rastrocchia46/Buck_Converter/3D View.pdf

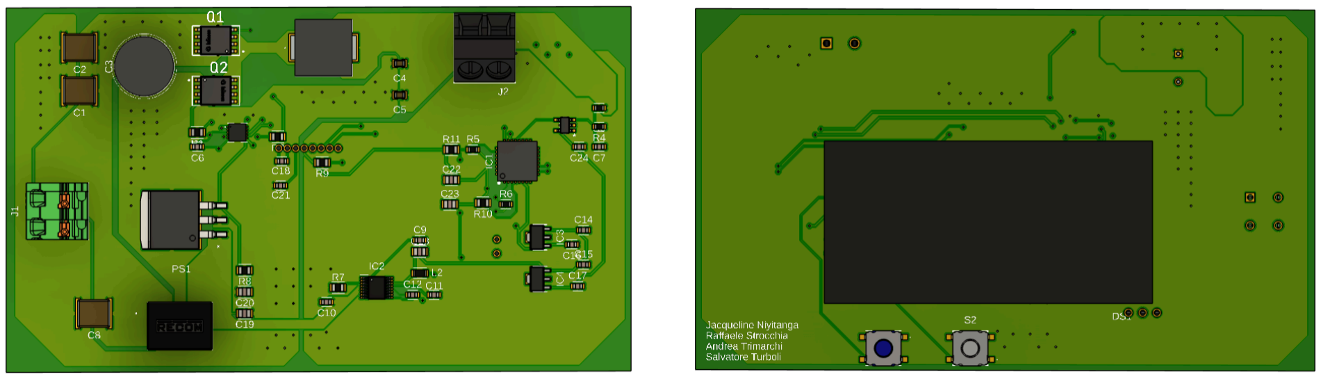
[picture p1: page 1]
