rastrocchia46/Buck_Converter/Bill of Material.xlsx

Sheet: EXAM v23 (2)
Column1 | Column2 | Column3 | Column4 | Column5 | Column6 | Column7 | Column8 | Column9 | Column10 | Column11 | Column12 | Column13 | Column14 | Column15 | Column16 | Column17 | Column18 | Column19 | Column20 | Column21 | Column22 | Column23 | Column24 | Column25 | Column26 | Column27 | Column28 | Column29 | Column30
Part | Value | Device | Package | Description | CATEGORY | COPYRIGHT | CURRENT_RATING | DATASHEET | DESCRIPTION | HEIGHT | MANUFACTURER | MANUFACTURER_NAME | MANUFACTURER_PART_NUMBER | MATERIAL_CORE | MOUSER_PART_NUMBER | MOUSER_PRICE-STOCK | MPN | OPERATING_TEMPERATURE | PACKAGE_SIZE | PACKAGE_TYPE | PART_STATUS | ROHS | SERIES | SUBCATEGORY | TEMPERATURE_COEFFICIENT | THERMALLOSS | TOLERANCE | TYPE | VOLTAGE_RATING
C1 | GRM55ER72A475KA01 | GRM55ER72A475KA01 | GRM55ER72A475KA01 | Ceramic SMT capacitor 4.7uF 100Vdc |  |  |  |  | Ceramic SMT capacitor 4.7uF 100Vdc | 2.7mm |  | Murata Electronics | GRM55ER72A475KA01L |  | 81-GRM55ER72A475KA01 | https://www.mouser.com/Search/Refine.aspx?Keyword=81-GRM55ER72A475KA01
C2 | GRM55ER72A475KA01 | GRM55ER72A475KA01 | GRM55ER72A475KA01 | Ceramic SMT capacitor 4.7uF 100Vdc |  |  |  |  | Ceramic SMT capacitor 4.7uF 100Vdc | 2.7mm |  | Murata Electronics | GRM55ER72A475KA01L |  | 81-GRM55ER72A475KA01 | https://www.mouser.com/Search/Refine.aspx?Keyword=81-GRM55ER72A475KA01
C3 | MAL213639479E3 | MAL213639479E3 | MAL213639479E3 | Vishay 47F 100V dc Aluminium Electrolytic Capacitor, Through Hole 10 (Dia.) x 16mm +105C 10mm 5mm |  |  |  |  | Vishay 47F 100V dc Aluminium Electrolytic Capacitor | Through Hole 10 (Dia.) x 16mm +105C 10mm 5mm | 17.5mm |  | Vishay | MAL213639479E3 |  | N/A | https://www.mouser.com/Search/Refine.aspx?Keyword=N%2FA
C4 | GRM21BR61C226ME44K | GRM21BR61C226ME44K | CAPC2012X145N | Multilayer Ceramic Capacitors MLCC - SMD/SMT |  |  |  |  | Multilayer Ceramic Capacitors MLCC - SMD/SMT | 1.45mm |  | Murata Electronics | GRM21BR61C226ME44K |  | 81-GRM21BR61C226ME4K | https://www.mouser.co.uk/ProductDetail/Murata-Electronics/GRM21BR61C226ME44K?qs=hNud%2FORuBR2WdjhUPKC1mw%3D%3D
C5 | GRM21BR61C226ME44K | GRM21BR61C226ME44K | CAPC2012X145N | Multilayer Ceramic Capacitors MLCC - SMD/SMT |  |  |  |  | Multilayer Ceramic Capacitors MLCC - SMD/SMT | 1.45mm |  | Murata Electronics | GRM21BR61C226ME44K |  | 81-GRM21BR61C226ME4K | https://www.mouser.co.uk/ProductDetail/Murata-Electronics/GRM21BR61C226ME44K?qs=hNud%2FORuBR2WdjhUPKC1mw%3D%3D
C6 | 7.2n | C_CHIP-0603(1608-METRIC) | CAPC1608X85 | Capacitor - Generic | Capacitor |  |  |  |  |  |  |  |  |  |  |  |  |  | 0603 | Surface Mount |  |  |  | Ceramic Capacitors |  |  |  | MLCC
C7 | 1.5n | C_CHIP-0603(1608-METRIC) | CAPC1608X85 | Capacitor - Generic | Capacitor |  |  |  |  |  |  |  |  |  |  |  |  |  | 0603 | Surface Mount |  |  |  | Ceramic Capacitors |  |  |  | MLCC
C8 | GRM55ER72A475KA01 | GRM55ER72A475KA01 | GRM55ER72A475KA01 | Ceramic SMT capacitor 4.7uF 100Vdc |  |  |  |  | Ceramic SMT capacitor 4.7uF 100Vdc | 2.7mm |  | Murata Electronics | GRM55ER72A475KA01L |  | 81-GRM55ER72A475KA01 | https://www.mouser.com/Search/Refine.aspx?Keyword=81-GRM55ER72A475KA01
C9 | 1u | C_CHIP-0603(1608-METRIC) | CAPC1608X85 | Capacitor - Generic | Capacitor |  |  |  |  |  |  |  |  |  |  |  |  |  | 0603 | Surface Mount |  |  |  | Ceramic Capacitors |  |  |  | MLCC
C10 | 4.7u | C_CHIP-0603(1608-METRIC) | CAPC1608X85 | Capacitor - Generic | Capacitor |  |  |  |  |  |  |  |  |  |  |  |  |  | 0603 | Surface Mount |  |  |  | Ceramic Capacitors |  |  |  | MLCC
C11 | 1u | C_CHIP-0603(1608-METRIC) | CAPC1608X85 | Capacitor - Generic | Capacitor |  |  |  |  |  |  |  |  |  |  |  |  |  | 0603 | Surface Mount |  |  |  | Ceramic Capacitors |  |  |  | MLCC
C12 | 0.1u | C_CHIP-0603(1608-METRIC) | CAPC1608X85 | Capacitor - Generic | Capacitor |  |  |  |  |  |  |  |  |  |  |  |  |  | 0603 | Surface Mount |  |  |  | Ceramic Capacitors |  |  |  | MLCC
C13 | 100u | C_CHIP-0805(2012-METRIC) | CAPC2012X110 | Capacitor - Generic | Capacitor |  |  |  |  |  |  |  |  |  |  |  |  |  | 0805 | Surface Mount |  |  |  | Ceramic Capacitors |  |  |  | MLCC
C14 | 1u | C_CHIP-0603(1608-METRIC) | CAPC1608X85 | Capacitor - Generic | Capacitor |  |  |  |  |  |  |  |  |  |  |  |  |  | 0603 | Surface Mount |  |  |  | Ceramic Capacitors |  |  |  | MLCC
C15 | 1u | C_CHIP-0603(1608-METRIC) | CAPC1608X85 | Capacitor - Generic | Capacitor |  |  |  |  |  |  |  |  |  |  |  |  |  | 0603 | Surface Mount |  |  |  | Ceramic Capacitors |  |  |  | MLCC
C16 | 1u | C_CHIP-0603(1608-METRIC) | CAPC1608X85 | Capacitor - Generic | Capacitor |  |  |  |  |  |  |  |  |  |  |  |  |  | 0603 | Surface Mount |  |  |  | Ceramic Capacitors |  |  |  | MLCC
C17 | 1u | C_CHIP-0603(1608-METRIC) | CAPC1608X85 | Capacitor - Generic | Capacitor |  |  |  |  |  |  |  |  |  |  |  |  |  | 0603 | Surface Mount |  |  |  | Ceramic Capacitors |  |  |  | MLCC
C18 | 1u | C_CHIP-0603(1608-METRIC) | CAPC1608X85 | Capacitor - Generic | Capacitor |  |  |  |  |  |  |  |  |  |  |  |  |  | 0603 | Surface Mount |  |  |  | Ceramic Capacitors |  |  |  | MLCC
C19 | 0.47u | C_CHIP-0805(2012-METRIC) | CAPC2012X110 | Capacitor - Generic | Capacitor |  |  |  |  |  |  |  |  |  |  |  |  |  | 0805 | Surface Mount |  |  |  | Ceramic Capacitors |  |  |  | MLCC
C20 | 22u | C_CHIP-0805(2012-METRIC) | CAPC2012X110 | Capacitor - Generic | Capacitor |  |  |  |  |  |  |  |  |  |  |  |  |  | 0805 | Surface Mount |  |  |  | Ceramic Capacitors |  |  |  | MLCC
C21 | 1u | C_CHIP-0603(1608-METRIC) | CAPC1608X85 | Capacitor - Generic | Capacitor |  |  |  |  |  |  |  |  |  |  |  |  |  | 0603 | Surface Mount |  |  |  | Ceramic Capacitors |  |  |  | MLCC
C22 | 0.1u | C_CHIP-0805(2012-METRIC) | CAPC2012X110 | Capacitor - Generic | Capacitor |  |  |  |  |  |  |  |  |  |  |  |  |  | 0805 | Surface Mount |  |  |  | Ceramic Capacitors |  |  |  | MLCC
C23 | 0.1u | C_CHIP-0805(2012-METRIC) | CAPC2012X110 | Capacitor - Generic | Capacitor |  |  |  |  |  |  |  |  |  |  |  |  |  | 0805 | Surface Mount |  |  |  | Ceramic Capacitors |  |  |  | MLCC
C24 | 0.1u | C_CHIP-0603(1608-METRIC) | CAPC1608X85 | Capacitor - Generic | Capacitor |  |  |  |  |  |  |  |  |  |  |  |  |  | 0603 | Surface Mount |  |  |  | Ceramic Capacitors |  |  |  | MLCC
DS1 | NHD-C0216CIZ-FSW-FBW-3V3 | NHD-C0216CIZ-FSW-FBW-3V3 | NHD-C0216CIZ-FSW-FBW-3V3 | LCD Character Display Modules & Accessories FSTN (+) Transfl 56.0 x 25.3 x 5.5 |  |  |  |  | LCD Character Display Modules & Accessories FSTN (+) Transfl 56.0 x 25.3 x 5.5 | mm |  | Newhaven Display | NHD-C0216CiZ-FSW-FBW-3V3 |  | 763-C0216CIZFSWFBW3V | https://www.mouser.co.uk/ProductDetail/Newhaven-Display/NHD-C0216CiZ-FSW-FBW-3V3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
IC1 | LPC1313FHN33_01,55 | LPC1313FHN33_01,55 | QFN65P700X700X100-33N | ARM Microcontrollers - MCU 32B CORTEX-M3 32KB FL/8KB SRAM |  |  |  |  | ARM Microcontrollers - MCU 32B CORTEX-M3 32KB FL/8KB SRAM | 1mm |  | NXP | LPC1313FHN33/01 | 55 |  | 771-LPC1313FHN330155 | https://www.mouser.co.uk/ProductDetail/NXP-Semiconductors/LPC1313FHN33-0155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
IC2 | LT8610AEMSE#PBF | LT8610AEMSE#PBF | LT8610A | Linear Technology, LT8610AEMSE#PBF DC-DC Converter 2.5A Adjustable 16-Pin, MSOP |  |  |  |  | Linear Technology | LT8610AEMSE#PBF DC-DC Converter 2.5A Adjustable 16-Pin | MSOP | 1.1mm |  | Analog Devices | LT8610AEMSE#PBF |  | 584-LT8610AEMSE#PBF | https://www.mouser.co.uk/ProductDetail/Analog-Devices/LT8610AEMSEPBF?qs=hVkxg5c3xu%252BXCM0J%252BSz08Q%3D%3D
IC3 | AP7387Q-33Y-13 | AP7387Q-33Y-13 | AP7387Q | LDO Voltage Regulators LDO CMOS LowCurr SOT89 T&R 2.5K |  |  |  |  | LDO Voltage Regulators LDO CMOS LowCurr SOT89 T&R 2.5K | mm |  | Diodes Incorporated | AP7387Q-33Y-13 |  | 621-AP7387Q-33Y-13 | https://www.mouser.co.uk/ProductDetail/Diodes-Incorporated/AP7387Q-33Y-13?qs=Y0Uzf4wQF3kvZEnH8zEZig%3D%3D
IC4 | AP7387Q-33Y-13 | AP7387Q-33Y-13 | AP7387Q | LDO Voltage Regulators LDO CMOS LowCurr SOT89 T&R 2.5K |  |  |  |  | LDO Voltage Regulators LDO CMOS LowCurr SOT89 T&R 2.5K | mm |  | Diodes Incorporated | AP7387Q-33Y-13 |  | 621-AP7387Q-33Y-13 | https://www.mouser.co.uk/ProductDetail/Diodes-Incorporated/AP7387Q-33Y-13?qs=Y0Uzf4wQF3kvZEnH8zEZig%3D%3D
J1 | 1071045 | 1071045 | 1071045 | 1-Fixed Terminal Blocks SPTAF 1/ 2-5 0-EL-EX |  |  |  |  | 1-Fixed Terminal Blocks SPTAF 1/ 2-5 0-EL-EX | 10.2mm |  | Phoenix Contact | 1071045 |  | 651-1071045 | https://www.mouser.co.uk/ProductDetail/Phoenix-Contact/1071045?qs=CUBnOrq4ZJwaBOz3kExfEw%3D%3D
J2 | 39543-4302 | 39543-4302 | 395434302 | (5.00mm) Through Hole |  |  |  |  | (5.00mm) Through Hole | 12.6mm |  | Molex | 39543-4302 |  | 538-39543-4302 | https://www.mouser.co.uk/ProductDetail/Molex/39543-4302?qs=4dAX1jW9NQpntxHfWEE3YA%3D%3D
L1 | SRP1038WA-4R7M | SRP1038WA-4R7M | SRP1038WA4R7M | Ind,11x10x3.8mm,4.7uH+/-20%,11A,shd |  |  |  |  | Ind | 11x10x3.8mm | 4.7uH+/-20% | 11A | shd | 4mm |  | Bourns | SRP1038WA-4R7M |  | 652-SRP1038WA-4R7M | https://www.mouser.co.uk/ProductDetail/Bourns/SRP1038WA-4R7M?qs=Li%252BoUPsLEnt%252BeSqNInK2UA%3D%3D
L2 | 10u | L_CHIP-0805(2012-METRIC) | INDC2009X120 | Inductor Fixed - Generic | Inductors |  |  |  | Chip 2.00 X 0.90 X 1.20 mm body 0805(2012-METRIC) |  |  |  |  |  |  |  |  |  | 0805 | Surface Mount
PS1 | R-78HB15-0.5 | R-78HB15-0.5 | R78HB3305 | Recom Switching Regulator, 20 ??72V Input, 15V Output, 0.5A%0 |  |  |  |  | Recom Switching Regulator | 20 ??72V Input | 15V Output | 0.5A%0 | 17.5mm |  | RECOM Power | R-78HB15-0.5 |  | 919-R-78HB15-0.5 | https://www.mouser.co.uk/ProductDetail/RECOM-Power/R-78HB15-05?qs=XF8hdbuHJAXLTh4WSjHftA%3D%3D
Q1 | IAUCN10S7L040 | IAUCN10S7L040 | IAUCN10S7L040
Q2 | IAUCN10S7L040 | IAUCN10S7L040 | IAUCN10S7L040
R1 | 1.3 | R_CHIP-0805(2012-METRIC) | RESC2012X65 | Resistor Fixed - Generic | Resistors |  |  |  | Chip Resistor 2.00 X 1.25 X 0.65 mm body 0805(2012-METRIC) Package |  |  |  |  |  |  |  |  |  | 0805 | Surface Mount
R2 | 1.3 | R_CHIP-0805(2012-METRIC) | RESC2012X65 | Resistor Fixed - Generic | Resistors |  |  |  | Chip Resistor 2.00 X 1.25 X 0.65 mm body 0805(2012-METRIC) Package |  |  |  |  |  |  |  |  |  | 0805 | Surface Mount
R3 | 10k | R_CHIP-0603(1608-METRIC) | RESC1608X60 | Resistor Fixed - Generic | Resistors |  |  |  | Chip Resistor 1.60 X 0.82 X 0.60 mm body 0603(1608-METRIC) Package |  |  |  |  |  |  |  |  |  | 0603 | Surface Mount
R4 | 20k | R_CHIP-0603(1608-METRIC) | RESC1608X60 | Resistor Fixed - Generic | Resistors |  |  |  | Chip Resistor 1.60 X 0.82 X 0.60 mm body 0603(1608-METRIC) Package |  |  |  |  |  |  |  |  |  | 0603 | Surface Mount
R5 | 10k | R_CHIP-0603(1608-METRIC) | RESC1608X60 | Resistor Fixed - Generic | Resistors |  |  |  | Chip Resistor 1.60 X 0.82 X 0.60 mm body 0603(1608-METRIC) Package |  |  |  |  |  |  |  |  |  | 0603 | Surface Mount
R6 | 10k | R_CHIP-0603(1608-METRIC) | RESC1608X60 | Resistor Fixed - Generic | Resistors |  |  |  | Chip Resistor 1.60 X 0.82 X 0.60 mm body 0603(1608-METRIC) Package |  |  |  |  |  |  |  |  |  | 0603 | Surface Mount
R7 | 110k | R_CHIP-0805(2012-METRIC) | RESC2012X65 | Resistor Fixed - Generic | Resistors |  |  |  | Chip Resistor 2.00 X 1.25 X 0.65 mm body 0805(2012-METRIC) Package |  |  |  |  |  |  |  |  |  | 0805 | Surface Mount
R8 | 0.5 | R_CHIP-0805(2012-METRIC) | RESC2012X65 | Resistor Fixed - Generic | Resistors |  |  |  | Chip Resistor 2.00 X 1.25 X 0.65 mm body 0805(2012-METRIC) Package |  |  |  |  |  |  |  |  |  | 0805 | Surface Mount
R9 | 22 | R_CHIP-0805(2012-METRIC) | RESC2012X65 | Resistor Fixed - Generic | Resistors |  |  |  | Chip Resistor 2.00 X 1.25 X 0.65 mm body 0805(2012-METRIC) Package |  |  |  |  |  |  |  |  |  | 0805 | Surface Mount
R10 | 10k | R_CHIP-0805(2012-METRIC) | RESC2012X65 | Resistor Fixed - Generic | Resistors |  |  |  | Chip Resistor 2.00 X 1.25 X 0.65 mm body 0805(2012-METRIC) Package |  |  |  |  |  |  |  |  |  | 0805 | Surface Mount
R11 | 10k | R_CHIP-0805(2012-METRIC) | RESC2012X65 | Resistor Fixed - Generic | Resistors |  |  |  | Chip Resistor 2.00 X 1.25 X 0.65 mm body 0805(2012-METRIC) Package |  |  |  |  |  |  |  |  |  | 0805 | Surface Mount
S1 | KSC721J_LFS | KSC721J_LFS | KSC721JLFS | Tactile Switches 4.3mmIP67 1.6N Soft Actuator J-Bend |  |  |  |  | Tactile Switches 4.3mmIP67 1.6N Soft Actuator J-Bend | 4.7mm |  | C & K COMPONENTS | KSC721J LFS |  | 611-KSC721JLFS | http://www.mouser.com/Search/ProductDetail.aspx?qs=15Q3o2KSIZY%2f1aaKjFUM2A%3d%3d
S2 | KSC253J_SP_DELTA_LFG | KSC253J_SP_DELTA_LFG | KSC253JSPDELTALFG | Tactile Switches 6.2 x 6.2mm, 3.mm height soft actuator, 5.5N, gold contact material |  |  |  |  | Tactile Switches 6.2 x 6.2mm | 3.mm height soft actuator | 5.5N | gold contact material | 3.5mm |  | C & K COMPONENTS | KSC253J SP DELTA LFG |  | 611-KSC253JSPDELTALF | https://www.mouser.co.uk/ProductDetail/CK/KSC253J-SP-DELTA-LFG?qs=i8QVZAFTkqRm%252BD28PDm3qw%3D%3D
U1 | TLV2781CDBVRDBV5 | TLV2781CDBVRDBV5 | DBV5 |  |  | Copyright (C) 2025 Ultra Librarian. All rights reserved. |  | https://www.ti.com/lit/gpn/tlv2781 | Single | 3.6-V | 8-MHz | RRIO operational amplifier 5-SOT-23 0 to 70 |  |  | Texas Instruments | TLV2781CDBVR
U2 | UCC27282DRCRVSON10_DRC_TEX | UCC27282DRCRVSON10_DRC_TEX | UCC27282 |  |  | Copyright (C) 2025 Ultra Librarian. All rights reserved. |  | https://www.ti.com/lit/gpn/ucc27282 | 3-A | 120-V half-bridge gate driver with 5-V UVLO | interlock and enable 10-VSON -40 to 125 |  |  | Texas Instruments | UCC27282DRCR
U3 | LM2940CS-12TS3B | LM2940CS-12TS3B | TS3B |  |  | Copyright (C) 2025 Ultra Librarian. All rights reserved. |  | https://www.ti.com/lit/gpn/lm2940c | 1-A | 26-V | high-PSRR | low-dropout voltage regulator 3-DDPAK/TO-263 0 to 125 |  |  | Texas Instruments | LM2940CS-12

Sheet: EXAM v23
Part,Value,Device,Package,Description,CATEGORY,COPYRIGHT,CURRENT_RATING,DATASHEET,DESCRIPTION,HEIGHT,MANUFACTURER,MANUFACTURER_NAME,MANUFACTURER_PART_NUMBER,MATERIAL_CORE,MOUSER_PART_NUMBER,MOUSER_PRICE-STOCK,MPN,OPERATING_TEMPERATURE,PACKAGE_SIZE,PACKAGE_TYPE,PART_STATUS,ROHS,SERIES,SUBCATEGORY,TEMPERATURE_COEFFICIENT,THERMALLOSS,TOLERANCE,TYPE,VOLTAGE_RATING
C1,GRM55ER72A475KA01,GRM55ER72A475KA01,GRM55ER72A475KA01,"Ceramic SMT capacitor 4.7uF 100Vdc",,,,,"Ceramic SMT capacitor 4.7uF 100Vdc",2.7mm,,"Murata Electronics",GRM55ER72A475KA01L,,81-GRM55ER72A475KA01,https://www.mouser.com/Search/Refine.aspx?Keyword=81-GRM55ER72A475KA01,,,,,,,,,,,,,
C2,GRM55ER72A475KA01,GRM55ER72A475KA01,GRM55ER72A475KA01,"Ceramic SMT capacitor 4.7uF 100Vdc",,,,,"Ceramic SMT capacitor 4.7uF 100Vdc",2.7mm,,"Murata Electronics",GRM55ER72A475KA01L,,81-GRM55ER72A475KA01,https://www.mouser.com/Search/Refine.aspx?Keyword=81-GRM55ER72A475KA01,,,,,,,,,,,,,
C3,MAL213639479E3,MAL213639479E3,MAL213639479E3,"Vishay 47F 100V dc Aluminium Electrolytic Capacitor, Through Hole 10 (Dia.) x 16mm +105C 10mm 5mm",,,,,"Vishay 47F 100V dc Aluminium Electrolytic Capacitor"," Through Hole 10 (Dia.) x 16mm +105C 10mm 5mm",17.5mm,,Vishay,MAL213639479E3,,N/A,https://www.mouser.com/Search/Refine.aspx?Keyword=N%2FA,,,,,,,,,,,,
C4,GRM21BR61C226ME44K,GRM21BR61C226ME44K,CAPC2012X145N,"Multilayer Ceramic Capacitors MLCC - SMD/SMT",,,,,"Multilayer Ceramic Capacitors MLCC - SMD/SMT",1.45mm,,"Murata Electronics",GRM21BR61C226ME44K,,81-GRM21BR61C226ME4K,https://www.mouser.co.uk/ProductDetail/Murata-Electronics/GRM21BR61C226ME44K?qs=hNud%2FORuBR2WdjhUPKC1mw%3D%3D,,,,,,,,,,,,,
C5,GRM21BR61C226ME44K,GRM21BR61C226ME44K,CAPC2012X145N,"Multilayer Ceramic Capacitors MLCC - SMD/SMT",,,,,"Multilayer Ceramic Capacitors MLCC - SMD/SMT",1.45mm,,"Murata Electronics",GRM21BR61C226ME44K,,81-GRM21BR61C226ME4K,https://www.mouser.co.uk/ProductDetail/Murata-Electronics/GRM21BR61C226ME44K?qs=hNud%2FORuBR2WdjhUPKC1mw%3D%3D,,,,,,,,,,,,,
C6,7.2n,C_CHIP-0603(1608-METRIC),CAPC1608X85,"Capacitor - Generic",Capacitor,,,,,,,,,,,,,,0603,"Surface Mount",,,,"Ceramic Capacitors",,,,MLCC,
C7,1.5n,C_CHIP-0603(1608-METRIC),CAPC1608X85,"Capacitor - Generic",Capacitor,,,,,,,,,,,,,,0603,"Surface Mount",,,,"Ceramic Capacitors",,,,MLCC,
C8,GRM55ER72A475KA01,GRM55ER72A475KA01,GRM55ER72A475KA01,"Ceramic SMT capacitor 4.7uF 100Vdc",,,,,"Ceramic SMT capacitor 4.7uF 100Vdc",2.7mm,,"Murata Electronics",GRM55ER72A475KA01L,,81-GRM55ER72A475KA01,https://www.mouser.com/Search/Refine.aspx?Keyword=81-GRM55ER72A475KA01,,,,,,,,,,,,,
C9,1u,C_CHIP-0603(1608-METRIC),CAPC1608X85,"Capacitor - Generic",Capacitor,,,,,,,,,,,,,,0603,"Surface Mount",,,,"Ceramic Capacitors",,,,MLCC,
C10,4.7u,C_CHIP-0603(1608-METRIC),CAPC1608X85,"Capacitor - Generic",Capacitor,,,,,,,,,,,,,,0603,"Surface Mount",,,,"Ceramic Capacitors",,,,MLCC,
C11,1u,C_CHIP-0603(1608-METRIC),CAPC1608X85,"Capacitor - Generic",Capacitor,,,,,,,,,,,,,,0603,"Surface Mount",,,,"Ceramic Capacitors",,,,MLCC,
C12,0.1u,C_CHIP-0603(1608-METRIC),CAPC1608X85,"Capacitor - Generic",Capacitor,,,,,,,,,,,,,,0603,"Surface Mount",,,,"Ceramic Capacitors",,,,MLCC,
C13,100u,C_CHIP-0805(2012-METRIC),CAPC2012X110,"Capacitor - Generic",Capacitor,,,,,,,,,,,,,,0805,"Surface Mount",,,,"Ceramic Capacitors",,,,MLCC,
C14,1u,C_CHIP-0603(1608-METRIC),CAPC1608X85,"Capacitor - Generic",Capacitor,,,,,,,,,,,,,,0603,"Surface Mount",,,,"Ceramic Capacitors",,,,MLCC,
C15,1u,C_CHIP-0603(1608-METRIC),CAPC1608X85,"Capacitor - Generic",Capacitor,,,,,,,,,,,,,,0603,"Surface Mount",,,,"Ceramic Capacitors",,,,MLCC,
C16,1u,C_CHIP-0603(1608-METRIC),CAPC1608X85,"Capacitor - Generic",Capacitor,,,,,,,,,,,,,,0603,"Surface Mount",,,,"Ceramic Capacitors",,,,MLCC,
C17,1u,C_CHIP-0603(1608-METRIC),CAPC1608X85,"Capacitor - Generic",Capacitor,,,,,,,,,,,,,,0603,"Surface Mount",,,,"Ceramic Capacitors",,,,MLCC,
C18,1u,C_CHIP-0603(1608-METRIC),CAPC1608X85,"Capacitor - Generic",Capacitor,,,,,,,,,,,,,,0603,"Surface Mount",,,,"Ceramic Capacitors",,,,MLCC,
C19,0.47u,C_CHIP-0805(2012-METRIC),CAPC2012X110,"Capacitor - Generic",Capacitor,,,,,,,,,,,,,,0805,"Surface Mount",,,,"Ceramic Capacitors",,,,MLCC,
C20,22u,C_CHIP-0805(2012-METRIC),CAPC2012X110,"Capacitor - Generic",Capacitor,,,,,,,,,,,,,,0805,"Surface Mount",,,,"Ceramic Capacitors",,,,MLCC,
C21,1u,C_CHIP-0603(1608-METRIC),CAPC1608X85,"Capacitor - Generic",Capacitor,,,,,,,,,,,,,,0603,"Surface Mount",,,,"Ceramic Capacitors",,,,MLCC,
C22,0.1u,C_CHIP-0805(2012-METRIC),CAPC2012X110,"Capacitor - Generic",Capacitor,,,,,,,,,,,,,,0805,"Surface Mount",,,,"Ceramic Capacitors",,,,MLCC,
C23,0.1u,C_CHIP-0805(2012-METRIC),CAPC2012X110,"Capacitor - Generic",Capacitor,,,,,,,,,,,,,,0805,"Surface Mount",,,,"Ceramic Capacitors",,,,MLCC,
C24,0.1u,C_CHIP-0603(1608-METRIC),CAPC1608X85,"Capacitor - Generic",Capacitor,,,,,,,,,,,,,,0603,"Surface Mount",,,,"Ceramic Capacitors",,,,MLCC,
DS1,NHD-C0216CIZ-FSW-FBW-3V3,NHD-C0216CIZ-FSW-FBW-3V3,NHD-C0216CIZ-FSW-FBW-3V3,"LCD Character Display Modules & Accessories FSTN (+) Transfl 56.0 x 25.3 x 5.5",,,,,"LCD Character Display Modules & Accessories FSTN (+) Transfl 56.0 x 25.3 x 5.5",mm,,"Newhaven Display",NHD-C0216CiZ-FSW-FBW-3V3,,763-C0216CIZFSWFBW3V,https://www.mouser.co.uk/ProductDetail/Newhaven-Display/NHD-C0216CiZ-FSW-FBW-3V3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,,,,,,,,,,,,,
IC1,"LPC1313FHN33_01,55","LPC1313FHN33_01,55",QFN65P700X700X100-33N,"ARM Microcontrollers - MCU 32B CORTEX-M3 32KB FL/8KB SRAM",,,,,"ARM Microcontrollers - MCU 32B CORTEX-M3 32KB FL/8KB SRAM",1mm,,NXP,LPC1313FHN33/01,55,,771-LPC1313FHN330155,https://www.mouser.co.uk/ProductDetail/NXP-Semiconductors/LPC1313FHN33-0155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,,,,,,,,,,,,
IC2,LT8610AEMSE#PBF,LT8610AEMSE#PBF,LT8610A,"Linear Technology, LT8610AEMSE#PBF DC-DC Converter 2.5A Adjustable 16-Pin, MSOP",,,,,"Linear Technology"," LT8610AEMSE#PBF DC-DC Converter 2.5A Adjustable 16-Pin"," MSOP",1.1mm,,"Analog Devices",LT8610AEMSE#PBF,,584-LT8610AEMSE#PBF,https://www.mouser.co.uk/ProductDetail/Analog-Devices/LT8610AEMSEPBF
IC3,AP7387Q-33Y-13,AP7387Q-33Y-13,AP7387Q,"LDO Voltage Regulators LDO CMOS LowCurr SOT89 T&R 2.5K",,,,,"LDO Voltage Regulators LDO CMOS LowCurr SOT89 T&R 2.5K",mm,,"Diodes Incorporated",AP7387Q-33Y-13,,621-AP7387Q-33Y-13,https://www.mouser.co.uk/ProductDetail/Diodes-Incorporated/AP7387Q-33Y-13?qs=Y0Uzf4wQF3kvZEnH8zEZig%3D%3D,,,,,,,,,,,,,
IC4,AP7387Q-33Y-13,AP7387Q-33Y-13,AP7387Q,"LDO Voltage Regulators LDO CMOS LowCurr SOT89 T&R 2.5K",,,,,"LDO Voltage Regulators LDO CMOS LowCurr SOT89 T&R 2.5K",mm,,"Diodes Incorporated",AP7387Q-33Y-13,,621-AP7387Q-33Y-13,https://www.mouser.co.uk/ProductDetail/Diodes-Incorporated/AP7387Q-33Y-13?qs=Y0Uzf4wQF3kvZEnH8zEZig%3D%3D,,,,,,,,,,,,,
J1,1071045,1071045,1071045,"1-Fixed Terminal Blocks SPTAF 1/ 2-5 0-EL-EX",,,,,"1-Fixed Terminal Blocks SPTAF 1/ 2-5 0-EL-EX",10.2mm,,"Phoenix Contact",1071045,,651-1071045,https://www.mouser.co.uk/ProductDetail/Phoenix-Contact/1071045?qs=CUBnOrq4ZJwaBOz3kExfEw%3D%3D,,,,,,,,,,,,,
J2,39543-4302,39543-4302,395434302," (5.00mm) Through Hole",,,,," (5.00mm) Through Hole",12.6mm,,Molex,39543-4302,,538-39543-4302,https://www.mouser.co.uk/ProductDetail/Molex/39543-4302?qs=4dAX1jW9NQpntxHfWEE3YA%3D%3D,,,,,,,,,,,,,
L1,SRP1038WA-4R7M,SRP1038WA-4R7M,SRP1038WA4R7M,"Ind,11x10x3.8mm,4.7uH+/-20%,11A,shd",,,,,Ind,11x10x3.8mm,4.7uH+/-20%,11A,shd,4mm,,Bourns,SRP1038WA-4R7M,,652-SRP1038WA-4R7M,https://www.mouser.co.uk/ProductDetail/Bourns/SRP1038WA-4R7M?qs=Li%252BoUPsLEnt%252BeSqNInK2UA%3D%3D,,,,,,,,,
L2,10u,L_CHIP-0805(2012-METRIC),INDC2009X120,"Inductor Fixed - Generic",Inductors,,,,"Chip 2.00 X 0.90 X 1.20 mm body 0805(2012-METRIC)",,,,,,,,,,0805,"Surface Mount",,,,,,,,,
PS1,R-78HB15-0.5,R-78HB15-0.5,R78HB3305,"Recom Switching Regulator, 20 ??72V Input, 15V Output, 0.5A%0",,,,,"Recom Switching Regulator"," 20 ??72V Input"," 15V Output"," 0.5A%0",17.5mm,,"RECOM Power",R-78HB15-0.5,,919-R-78HB15-0.5,https://www.mouser.co.uk/ProductDetail/RECOM-Power/R-78HB15-05?qs=XF8hdbuHJAXLTh4WSjHftA%3D%3D,,,,,,,,,,
Q1,IAUCN10S7L040,IAUCN10S7L040,IAUCN10S7L040,,,,,,,,,,,,,,,,,,,,,,,,,,
Q2,IAUCN10S7L040,IAUCN10S7L040,IAUCN10S7L040,,,,,,,,,,,,,,,,,,,,,,,,,,
R1,1.3,R_CHIP-0805(2012-METRIC),RESC2012X65,"Resistor Fixed - Generic",Resistors,,,,"Chip Resistor 2.00 X 1.25 X 0.65 mm body 0805(2012-METRIC) Package",,,,,,,,,,0805,"Surface Mount",,,,,,,,,
R2,1.3,R_CHIP-0805(2012-METRIC),RESC2012X65,"Resistor Fixed - Generic",Resistors,,,,"Chip Resistor 2.00 X 1.25 X 0.65 mm body 0805(2012-METRIC) Package",,,,,,,,,,0805,"Surface Mount",,,,,,,,,
R3,10k,R_CHIP-0603(1608-METRIC),RESC1608X60,"Resistor Fixed - Generic",Resistors,,,,"Chip Resistor 1.60 X 0.82 X 0.60 mm body 0603(1608-METRIC) Package",,,,,,,,,,0603,"Surface Mount",,,,,,,,,
R4,20k,R_CHIP-0603(1608-METRIC),RESC1608X60,"Resistor Fixed - Generic",Resistors,,,,"Chip Resistor 1.60 X 0.82 X 0.60 mm body 0603(1608-METRIC) Package",,,,,,,,,,0603,"Surface Mount",,,,,,,,,
R5,10k,R_CHIP-0603(1608-METRIC),RESC1608X60,"Resistor Fixed - Generic",Resistors,,,,"Chip Resistor 1.60 X 0.82 X 0.60 mm body 0603(1608-METRIC) Package",,,,,,,,,,0603,"Surface Mount",,,,,,,,,
R6,10k,R_CHIP-0603(1608-METRIC),RESC1608X60,"Resistor Fixed - Generic",Resistors,,,,"Chip Resistor 1.60 X 0.82 X 0.60 mm body 0603(1608-METRIC) Package",,,,,,,,,,0603,"Surface Mount",,,,,,,,,
R7,110k,R_CHIP-0805(2012-METRIC),RESC2012X65,"Resistor Fixed - Generic",Resistors,,,,"Chip Resistor 2.00 X 1.25 X 0.65 mm body 0805(2012-METRIC) Package",,,,,,,,,,0805,"Surface Mount",,,,,,,,,
R8,0.5,R_CHIP-0805(2012-METRIC),RESC2012X65,"Resistor Fixed - Generic",Resistors,,,,"Chip Resistor 2.00 X 1.25 X 0.65 mm body 0805(2012-METRIC) Package",,,,,,,,,,0805,"Surface Mount",,,,,,,,,
R9,22,R_CHIP-0805(2012-METRIC),RESC2012X65,"Resistor Fixed - Generic",Resistors,,,,"Chip Resistor 2.00 X 1.25 X 0.65 mm body 0805(2012-METRIC) Package",,,,,,,,,,0805,"Surface Mount",,,,,,,,,
R10,10k,R_CHIP-0805(2012-METRIC),RESC2012X65,"Resistor Fixed - Generic",Resistors,,,,"Chip Resistor 2.00 X 1.25 X 0.65 mm body 0805(2012-METRIC) Package",,,,,,,,,,0805,"Surface Mount",,,,,,,,,
R11,10k,R_CHIP-0805(2012-METRIC),RESC2012X65,"Resistor Fixed - Generic",Resistors,,,,"Chip Resistor 2.00 X 1.25 X 0.65 mm body 0805(2012-METRIC) Package",,,,,,,,,,0805,"Surface Mount",,,,,,,,,
S1,KSC721J_LFS,KSC721J_LFS,KSC721JLFS,"Tactile Switches 4.3mmIP67 1.6N Soft Actuator J-Bend",,,,,"Tactile Switches 4.3mmIP67 1.6N Soft Actuator J-Bend",4.7mm,,"C & K COMPONENTS","KSC721J LFS",,611-KSC721JLFS,http://www.mouser.com/Search/ProductDetail.aspx?qs=15Q3o2KSIZY%2f1aaKjFUM2A%3d%3d,,,,,,,,,,,,,
S2,KSC253J_SP_DELTA_LFG,KSC253J_SP_DELTA_LFG,KSC253JSPDELTALFG,"Tactile Switches 6.2 x 6.2mm, 3.mm height soft actuator, 5.5N, gold contact material",,,,,"Tactile Switches 6.2 x 6.2mm"," 3.mm height soft actuator"," 5.5N"," gold contact material",3.5mm,,"C & K COMPONENTS","KSC253J SP DELTA LFG",,611-KSC253JSPDELTALF,https://www.mouser.co.uk/ProductDetail/CK/KSC253J-SP-DELTA-LFG?qs=i8QVZAFTkqRm%252BD28PDm3qw%3D%3D,,,,,,,,,,
U1,TLV2781CDBVRDBV5,TLV2781CDBVRDBV5,DBV5,,,"Copyright (C) 2025 Ultra Librarian. All rights reserved.",,https://www.ti.com/lit/gpn/tlv2781,Single," 3.6-V"," 8-MHz"," RRIO operational amplifier 5-SOT-23 0 to 70",,,"Texas Instruments",TLV2781CDBVR,,,,,,,,,,,,,
U2,UCC27282DRCRVSON10_DRC_TEX,UCC27282DRCRVSON10_DRC_TEX,UCC27282,,,"Copyright (C) 2025 Ultra Librarian. All rights reserved.",,https://www.ti.com/lit/gpn/ucc27282,3-A," 120-V half-bridge gate driver with 5-V UVLO"," interlock and enable 10-VSON -40 to 125",,,"Texas Instruments",UCC27282DRCR,,,,,,,,,,,,,,
U3,LM2940CS-12TS3B,LM2940CS-12TS3B,TS3B,,,"Copyright (C) 2025 Ultra Librarian. All rights reserved.",,https://www.ti.com/lit/gpn/lm2940c,1-A," 26-V"," high-PSRR"," low-dropout voltage regulator 3-DDPAK/TO-263 0 to 125",,,"Texas Instruments",LM2940CS-12,,,,,,,,,,,,,
