rastrocchia46/Buck_Converter/Schematic v23.pdf

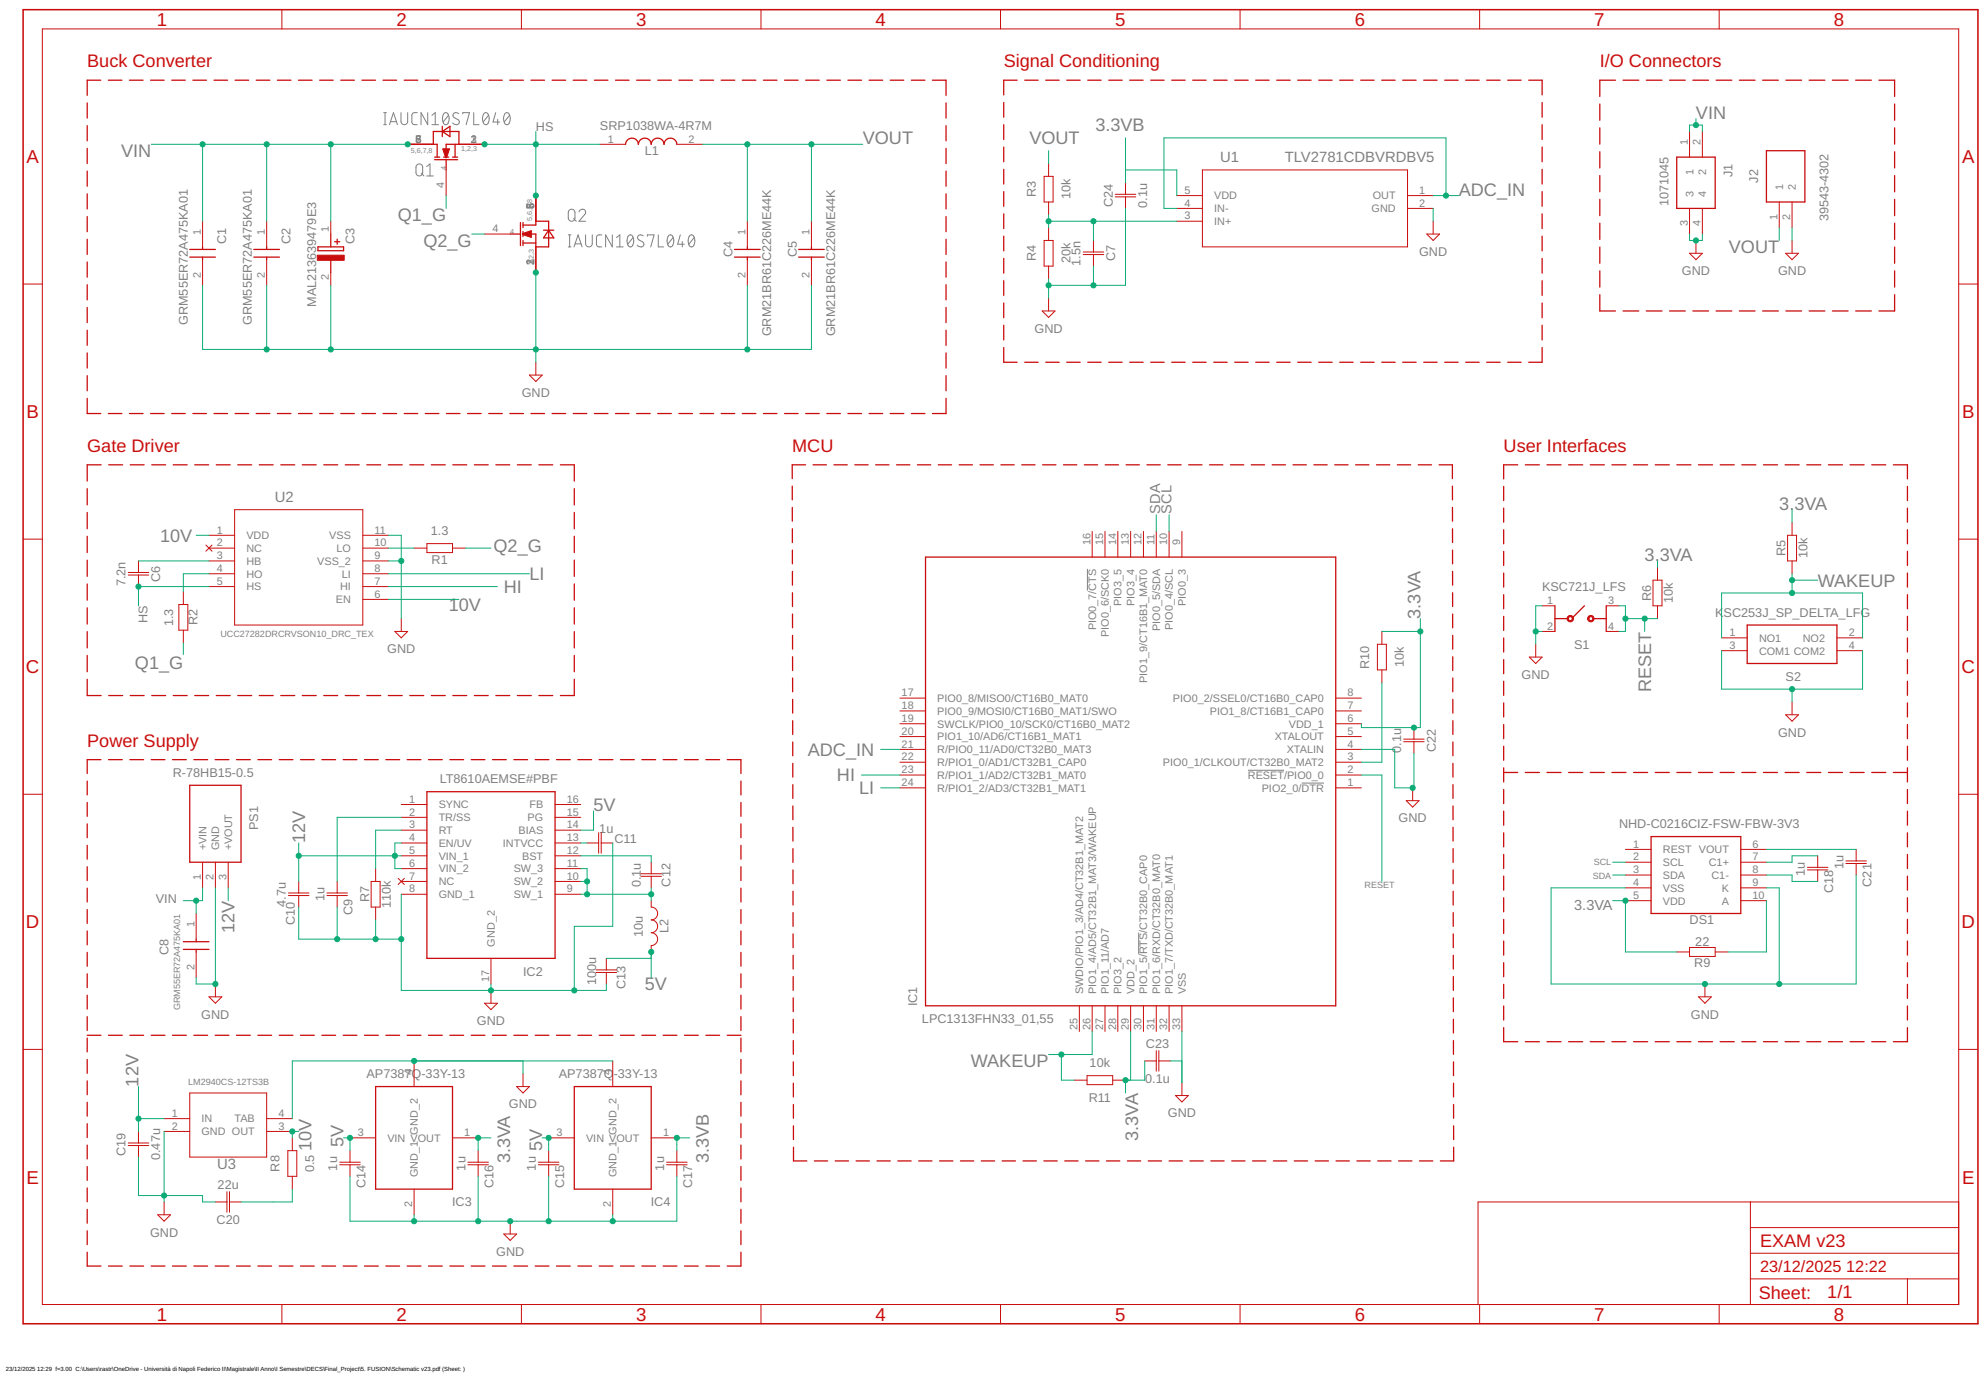
[picture p2: page 1]

Signal Conditioning

23/12/2025 12:29 f=3.00 C:\Users\rastr\OneDrive - Università di Napoli Federico II\Magistrale\II Anno\I Semestre\DECS\Final_Project\5. FUSION\Schematic v23.pdf (Sheet: )
