rastrocchia46/Buck_Converter/PCB_bottom v31.pdf

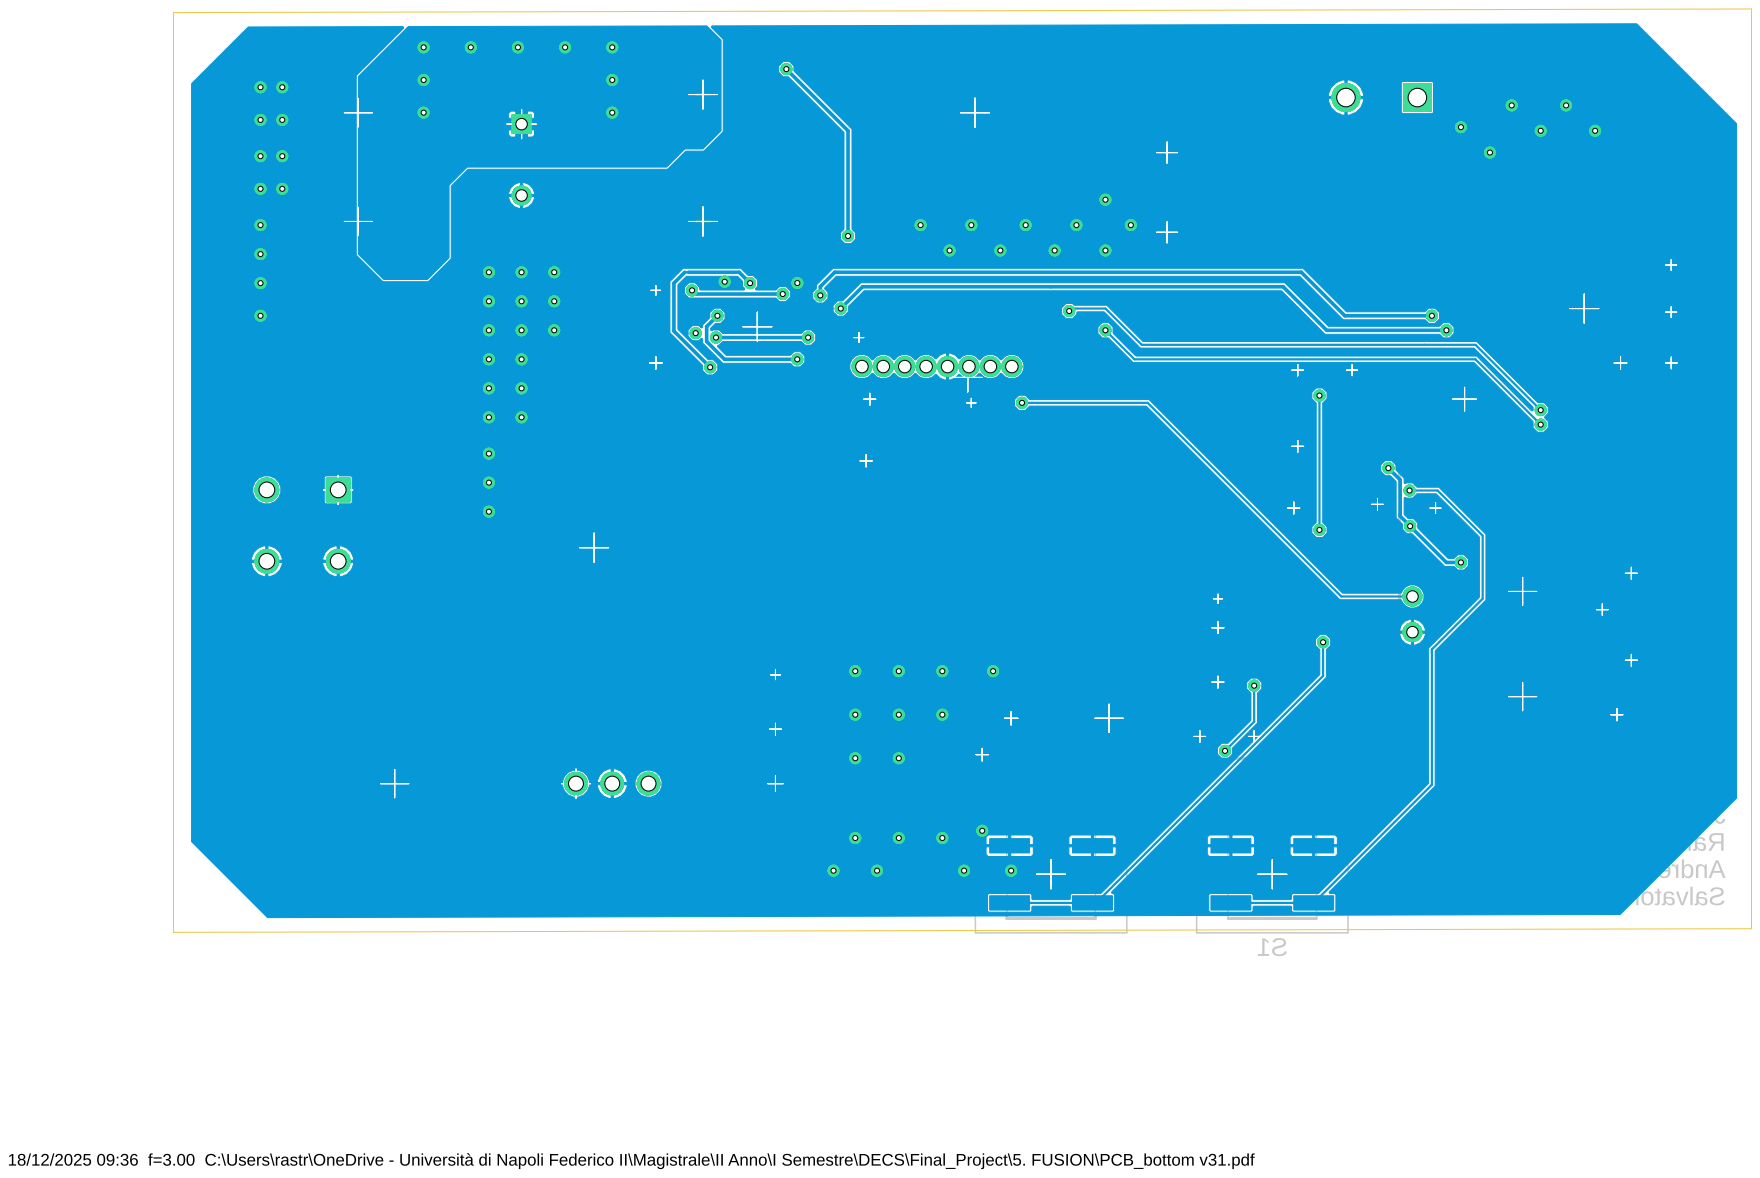
[picture p3: page 1]
