rastrocchia46/Buck_Converter/PCB_top v31.pdf

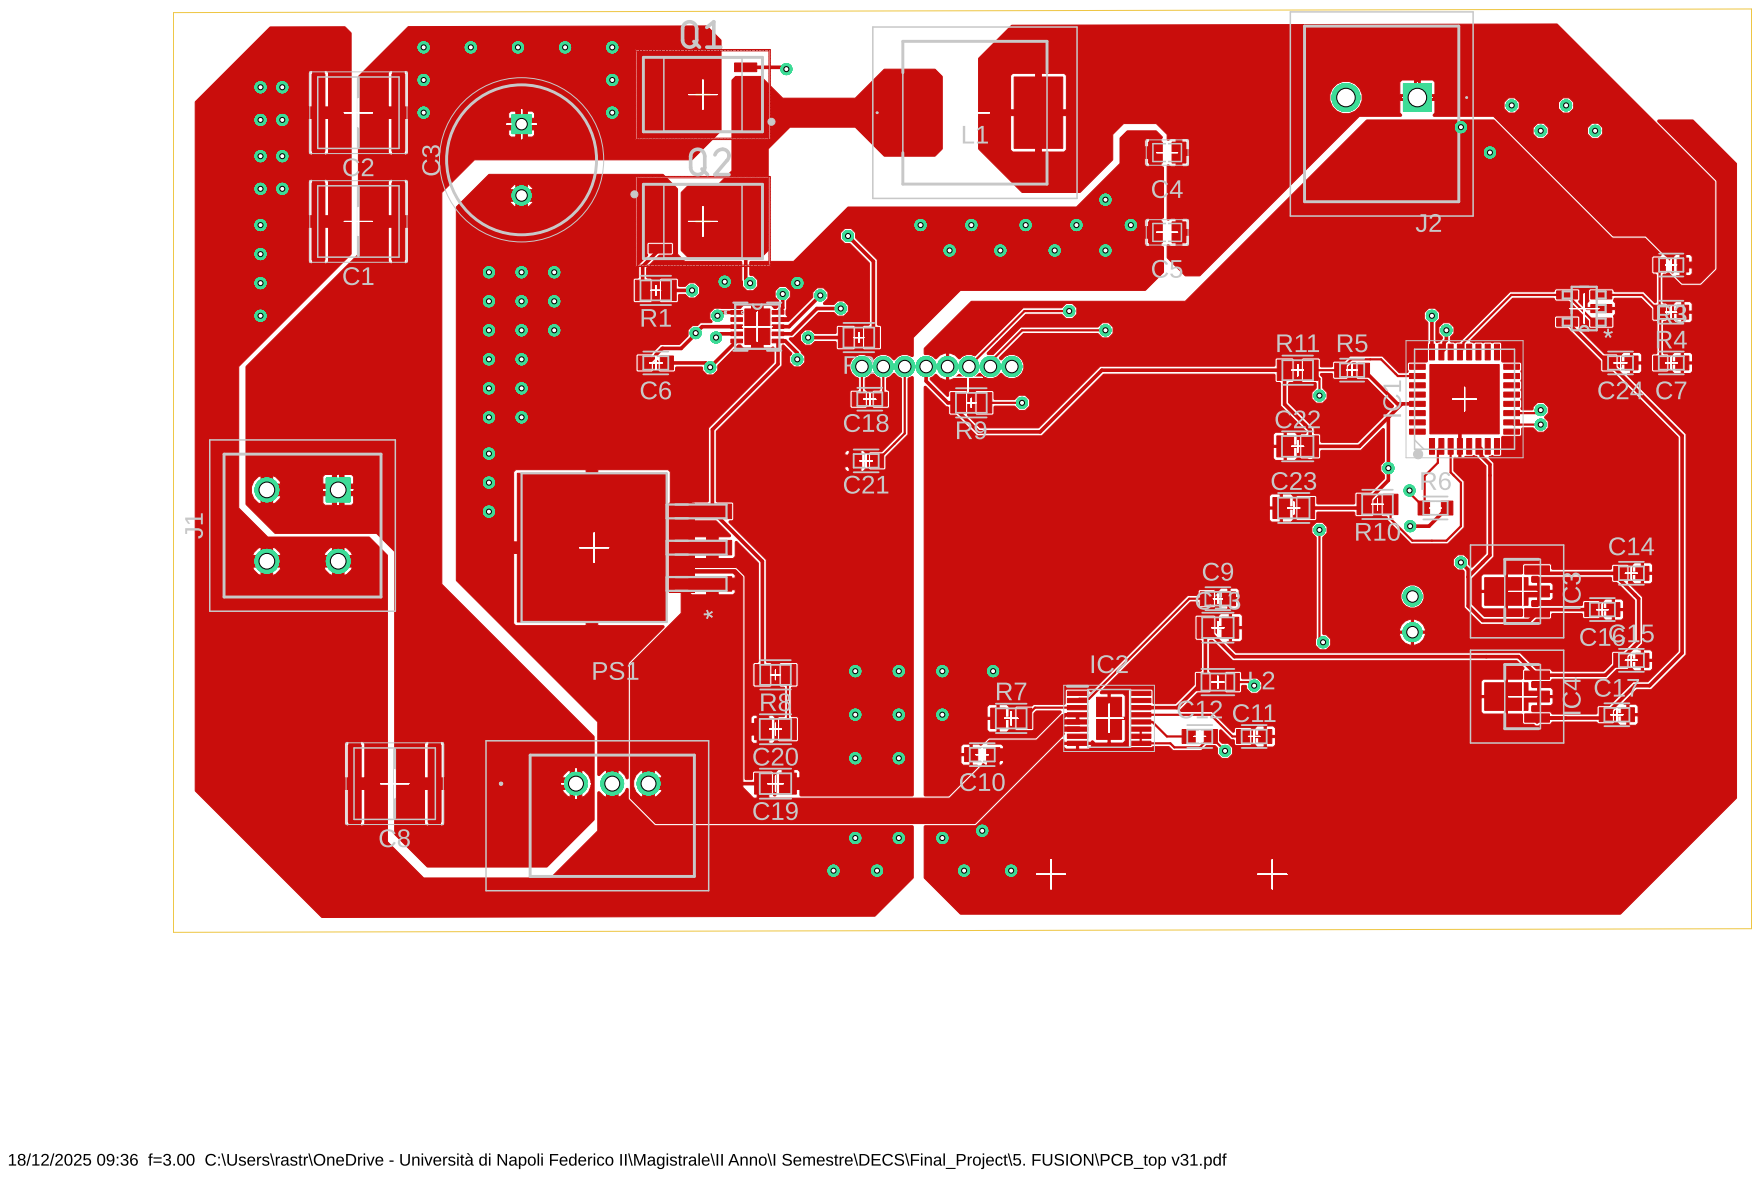
[picture p4: page 1]
