rastrocchia46/Buck_Converter/PCB_v31.pdf

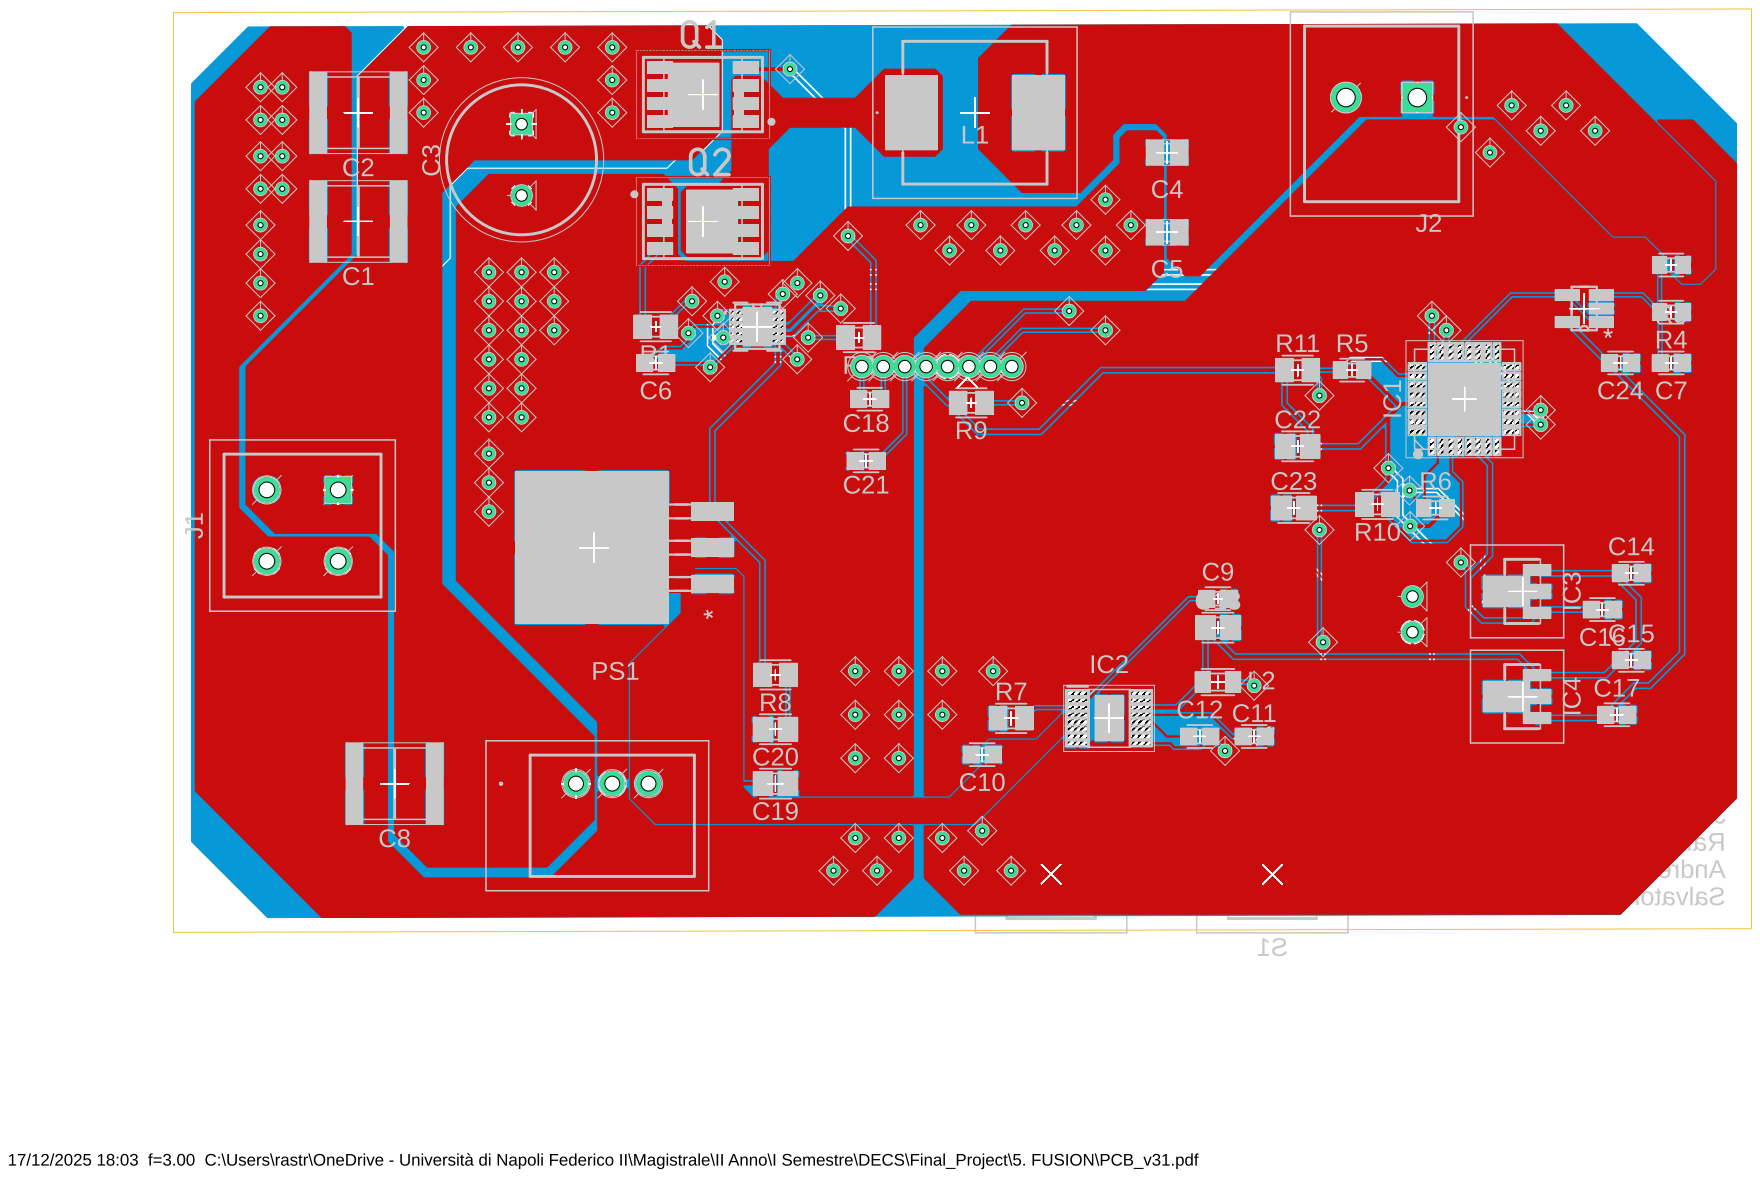
[picture p5: page 1]
