rastrocchia46/Buck_Converter/(list of files, drawings)

Other design files:
SIMetrix - Simulations/Libreries/IAUCN10S7L040 - MOSFET/OPTIMOS_7_100V_PSpice.olb
SIMetrix - Simulations/Libreries/UCC27282 - DRIVER/UCC27282.DSN
SIMetrix - Simulations/Libreries/UCC27282 - DRIVER/UCC27282.OLB
SIMetrix - Simulations/Libreries/UCC27282 - DRIVER/UCC27282.opj
